aspensmonster-school/ee4390-senior-design-i/presentation/README

This folder holds presentation-related material.
