aspensmonster-school/ee4390-senior-design-i/hw/README

This folder will contain hardware schematics, netlists, models, simulation 
data, waveforms, etc for the project.
