aspensmonster-school/ee4390-senior-design-i/research/more-links.md

More links to reference
=======================

  * "Power Density Spectrum of noise types" - https://en.wikipedia.org/wiki/Colors_of_noise
  * "A whole paper on tests" - http://csrc.nist.gov/groups/ST/toolkit/rng/documents/nissc-paper.pdf
  * "Tests" - http://www.comp-phys.org/software/rngts/tests/RNGTS_tests.html
  * "Description of various tests" - http://www.drdobbs.com/testing-random-number-generators/184403185
  * "Adversary Bias" - http://www1.spms.ntu.edu.sg/~kkhoongm/Entropy.pdf
  * "Null Hypothesis, Type I and Type II Errors" - http://www.eg.bucknell.edu/~xmeng/Course/CS6337/Note/master/node42.html
  * "Autocorrelation when using multiple generators" - https://en.wikipedia.org/wiki/Autocorrelation
  * "Power Supply Bypassing of Op-Amps" - http://tangentsoft.net/audio/hs-opamp.html
  * "Noise Models in Op-Amps" - http://www.siengineer.com/images/Tutorial_on_Op_Amp_Noise.pdf
  * Several pages from robertnz.net
    * "Hardware RNGs" - http://www.robertnz.net/hwrng.htm
    * "True RNGs" - http://www.robertnz.net/true_rng.html
    * "Paper on XOR post-processing" - http://www.robertnz.net/pdf/xor2.pdf
  * "ISAAC CSPRNG; look at issues with seeding!" - http://www.robertnz.net/pdf/xor2.pdf
  * "Good practical advice on interpreting tests here" - http://burtleburtle.net/bob/rand/testsfor.html
  * "DIE GROUND LOOPS DIE" - http://www.edn.com/electronics-blogs/signal-integrity/4403657/Ground-loops
  * "Analog vs Digital ground" - http://analogvsdigitalground.blogspot.com/p/various-grounds.html
  * "Grounding Demystified" - http://www.celectronics.com/seminar/sample/IEEE11-9-05.pdf
  * "Apparently the world's foremost expert on ground loops" - http://www.jensen-transformers.com/an/generic%20seminar.pdf
  * "Both pink and white noise exist in amplifiers and other semiconductors" - http://www.edn.com/electronics-blogs/the-signal/4408242/1-f-Noise-the-flickering-candle-
  * "Comparing de-biasing routines" http://www1.spms.ntu.edu.sg/~kkhoongm/Entropy.pdf
  * "Lots of links to other resources" http://www.cs.berkeley.edu/~daw/rnd/
  * "haven't looked at" https://www.merrymeet.com/jon/usingrandom.html#RTFToC1
  * "haven't looked at" http://www.ciphersbyritter.com/RES/NOISE.HTM
  * "haven't looked at" http://world.std.com/~reinhold/truenoise.html
