aspensmonster-school/ee4390-senior-design-i/research/f^-1_noise Matthias Strauch.pdf

# 1/f noise

# Matthias Strauch

28.10.2011

# Repetition: Noise

# d =R⋅s+n

# White Noise→ Gaussian noise → signal independent

# But: There's frequency dependent noise!

n=

1
∣2π N∣

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
# Colours of noise

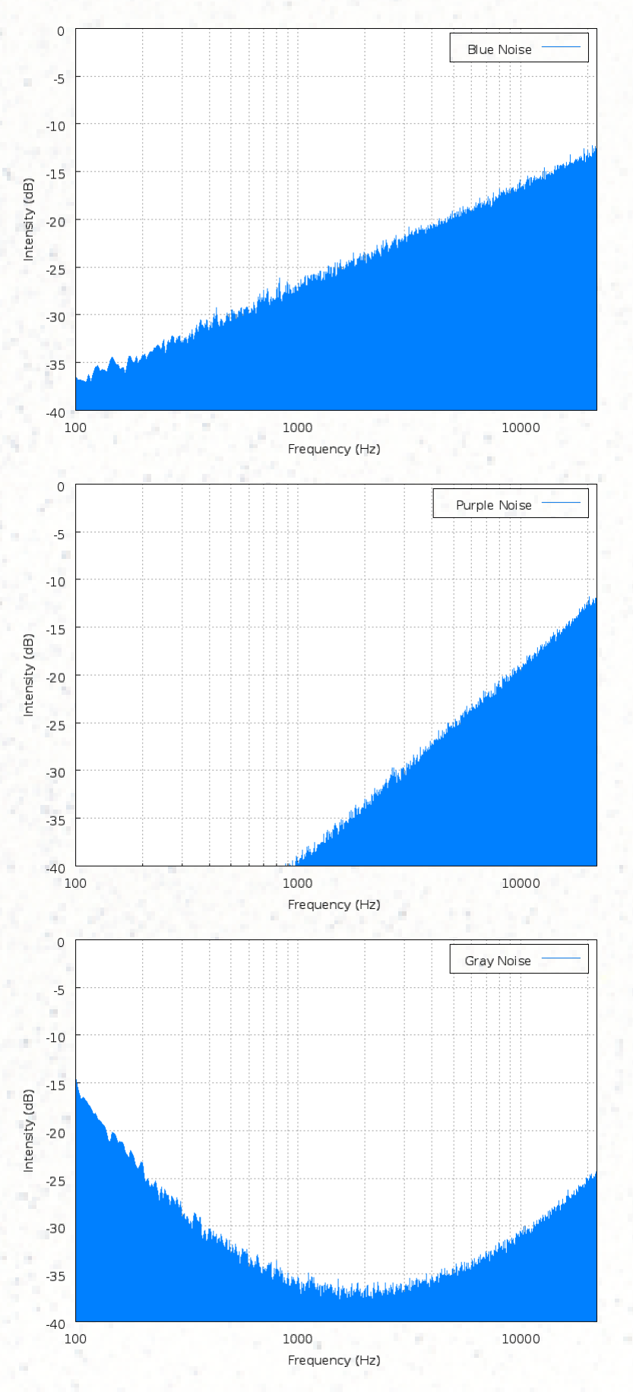
[picture p4: figure]

# - White

# - Pink

# - Brown

# - Blue

# - Violet

# - Grey

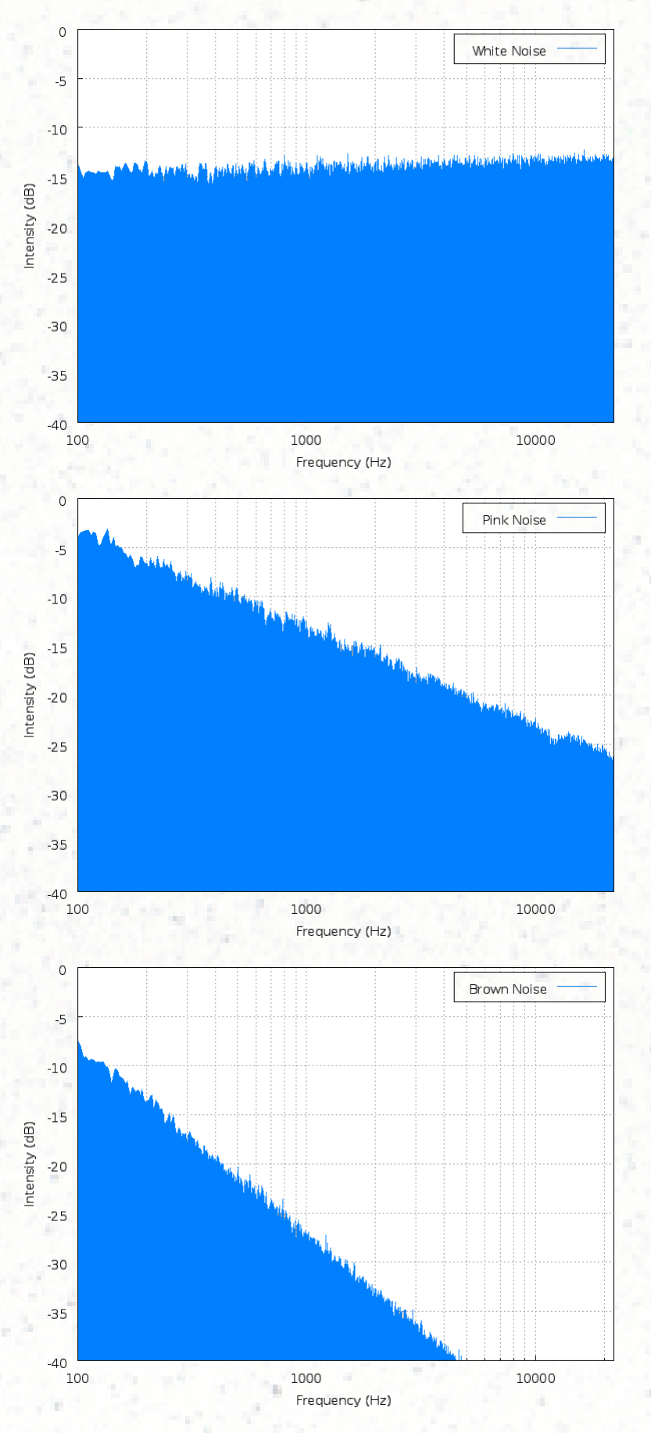
[picture p5: figure]

log(Noise power density) is plotted vs. log(f)

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
[1] Pictures created with Audacity

# Occurrence of noise

# - Acoustics - Visual - Electronic - Vibrational

# Kinds of electronic noise

# - Thermal (Johnson-Nyquist) noise - Shot noise - Burst noise - Avalanche noise - Flicker noise

# Measuring noise

# 1. Measure U/I 2. FFT 3. Calculate power density spectrum

# → Integrate over many measurements

# History of 1/f noise

- 1918
- 1925

# W. Schottky predicted the occurance of frequency-independent white noise

J. B. Johnson successfully measured it,

# but discovers unexpected “flicker noise” at low frequency

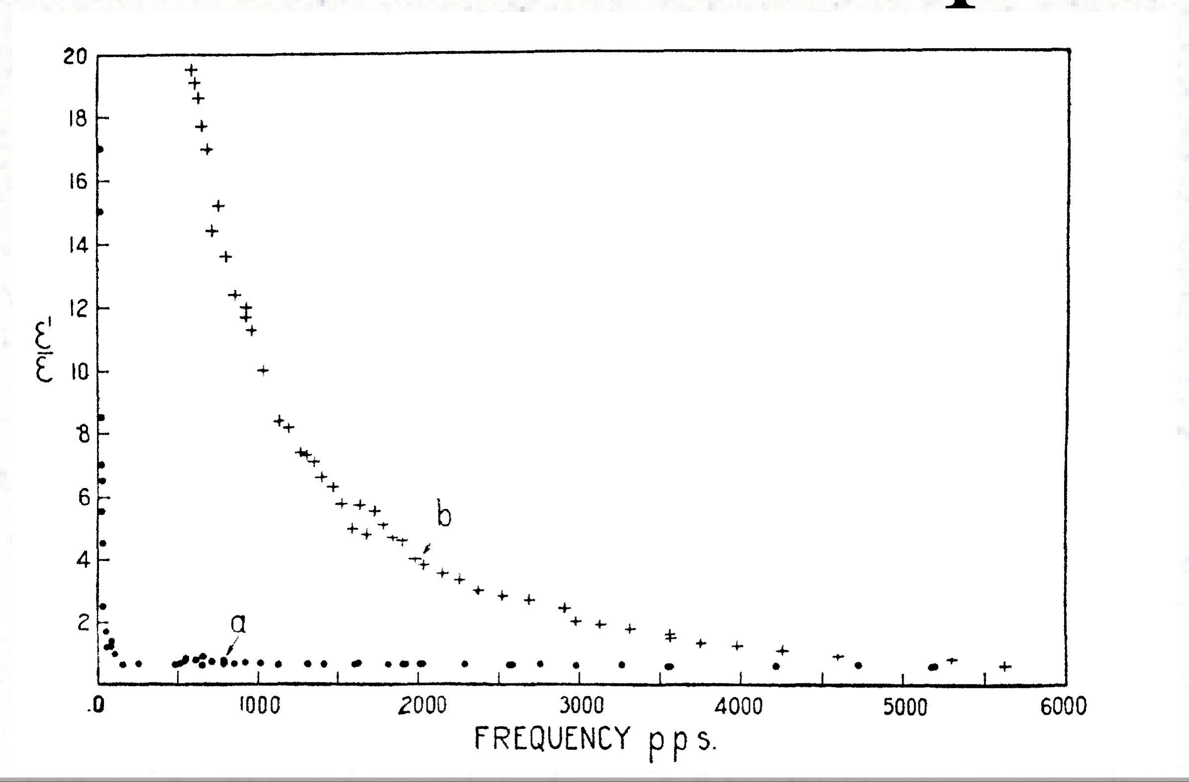
[picture p6: figure]

[2] W.Schottky Ann. d. Phys. 57 (1918) 157
[3] J.B. Johnson Phys. Rev. 26 (1925) 71

# Flicker Noise

# - behaviour

# - α range: 0.5 – 1.5

# - Extends: Several frequency decades!

1
f

α

# First explanation: W. Schottky 1926

# Ansatz: Superposition of relaxation processes N (t)=N0

e

−λ t
t≥0
F (ω)=∫

0

∞

# N (t)e

−iωt
=

N0

## λ+iω

# Now: Train of such pulses

F (ω)=∫

0

∞
∑

k

# N (t ,t

k

)e

−iωt
=

N0

## λ+iω∑

k

e

iωt
k

# N (t ,t

k

)=N0

e

−λ(t−t
k

)
t≥t
k
[4] W. Schottky, Phys. Rev. 28 (1926) 74

# Spectrum

# S (ω)=lim

t →∞

1
T

〈∣F (ω)∣

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
# n: average pulse rate

# → dependence 1

f

2

# 1/f dependence

S (ω)=

1
λ2−λ1

∫

λ1

λ2 N0
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
n | 0<ω≪λ1,λ2
N0

2
n π

## 2ω(λ1−λ2

)

## λ1≪ω≪λ2

N0

2
n
ω

2

## λ1, λ2≪ω ∣

# Uniform distributed relaxation rate between λ1, λ2

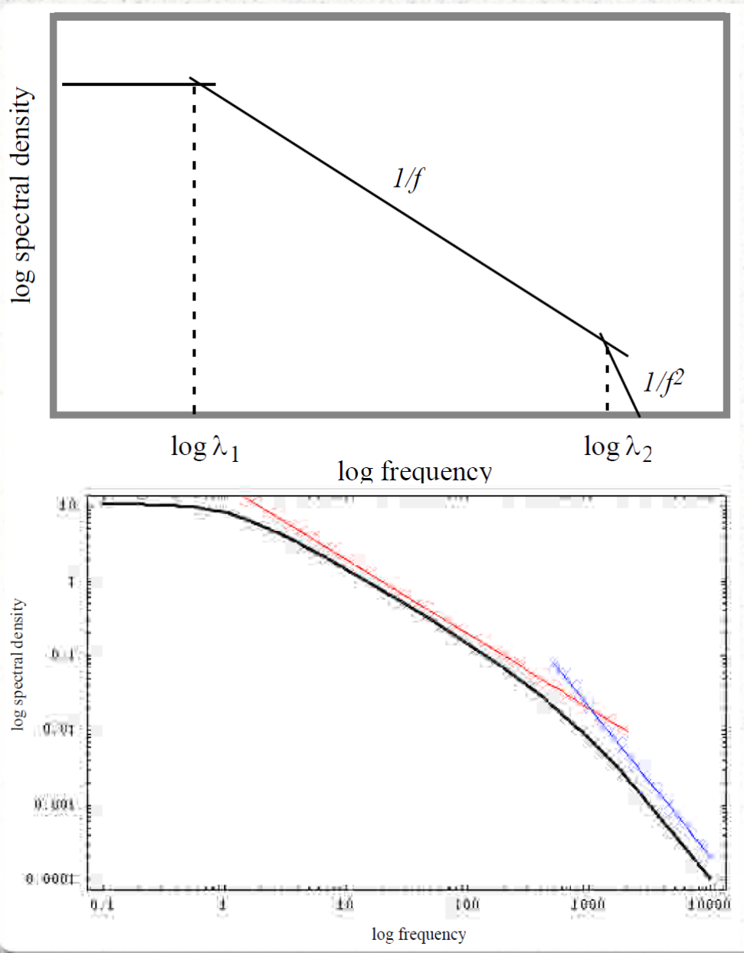
[picture p7: figure]

[5] E. Milotti arXiv:physics/0204033v1

# Non-uniform distribution

S (ω)∼

1
ω

1+β

# → Whole class of flicker noises with different exponents

# Infinitely large fluctuations?

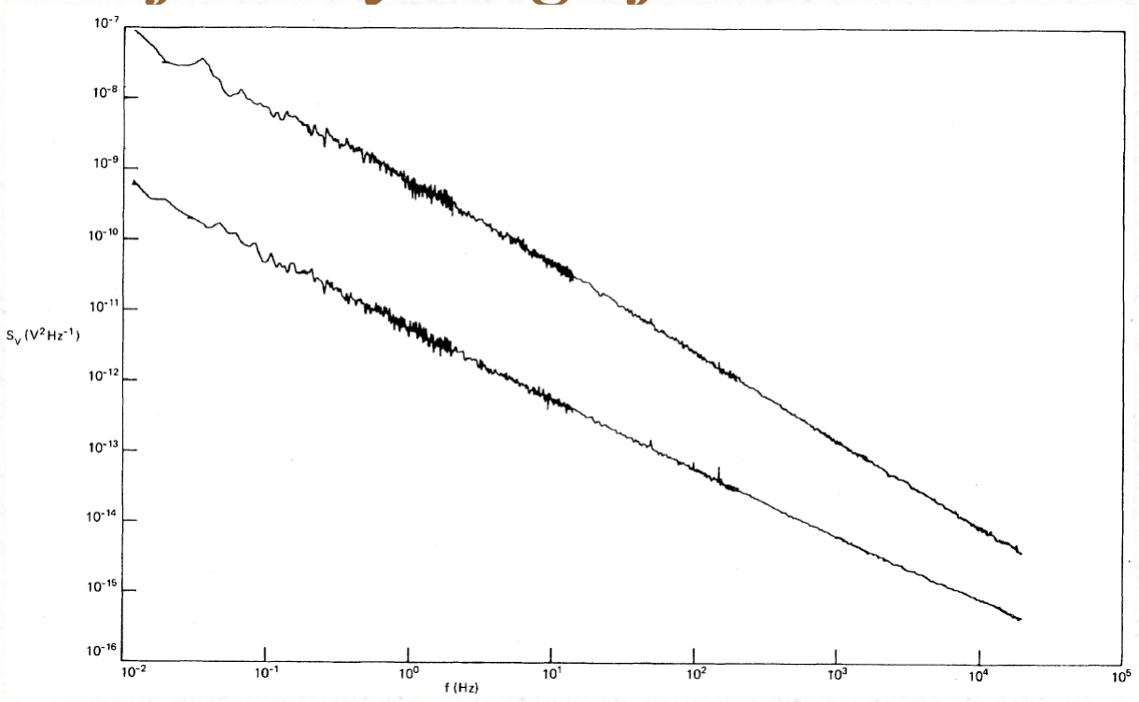
[picture p8: figure]

[6] B. Pellegrini, R.Saletti, P. Terreni and M. Prudenziati, Phys. Rev. B 27 (1983) 1233

# Don't worry!

∫

10⁻¹⁷ Hz

10⁴³ Hz df
f

# =ln(10⁶⁰)≈138

# Highest possible fluctuation can only be 138 times the total fluctuation between 1 Hz and 3 Hz

[7] I. Flinn Nature 219 (1968) 1356

# Investigation of Brownian motion

dx
dt

# =Gaussian(t)

# −iω X (ω)=Gaussian(ω)

S x
=

σ

2
2πω

2

Brownian motion has a | spectrum!
→ No description for | noise
| 1 f
| 2
1
f

# Diffusion processes

# In principle: - Possibility to derive flicker noise

# - But: No physical meaning

[8] P. Dutta and P. M. Horn, Rev. Mod. Phys. 17 (1945) 323
[9] E. Milotti Phys. Rev. E 51 (1995) 3087

# Bak Tang Wiesenfeld Model 1987

# - Sandpile model - Statistical approach: dependence - Numerical simulations: α near 1 - Confirmed by renormalization group Experiment: → Sandpiles doesn't behave like theory

## Reason: Calculation Error!

1
f

α

[10] P. Bak, C. Tang, K. Wiesenfeld, Phys. Rev. Lett. 59 (1987) 381
[11] H. M. Jaeger, C. Liu and S. R. Nagel, Phys. Rev. Lett. 62 (1989) 40
[12] H. J. Jensen, K. Christensen ans H. C. Fogedby, Phys. Rev. B 40 (1989) 7425

# Theoretical Conclusion:

# - Relaxation ansatz leads to wrong low and high frequency behaviour

# - Diffusion ansatz yields noise

# - Sandpile model not applicable

# → No true explanation yet

1
f

2

# Experiment: Sea Level at Bermuda

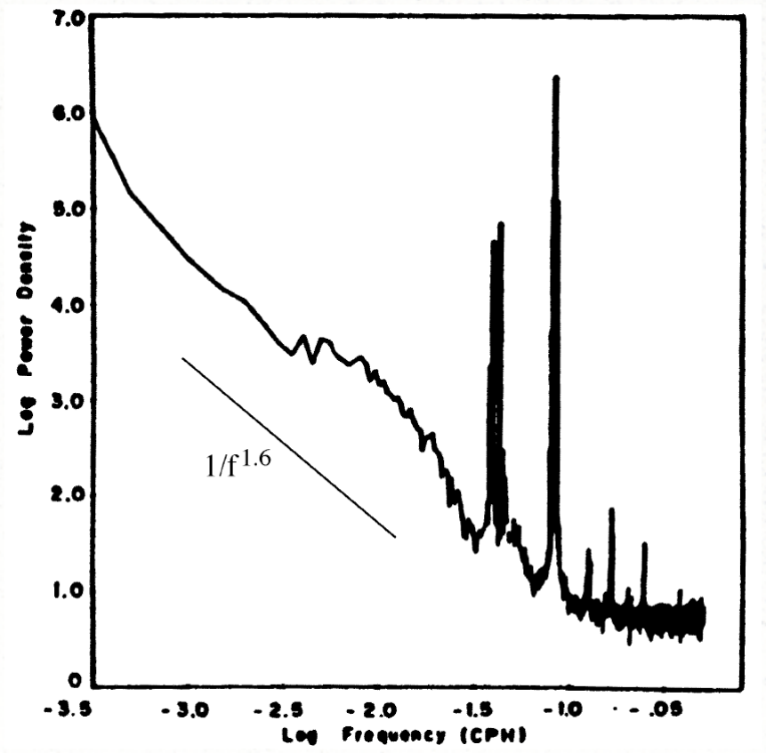
[picture p9: figure]

[13] C. Wunsch, Rev.
Geophys. and Space
Phys. 10 (1972) 1

# Loudness fluctuation spectra of different radio stations and Bach

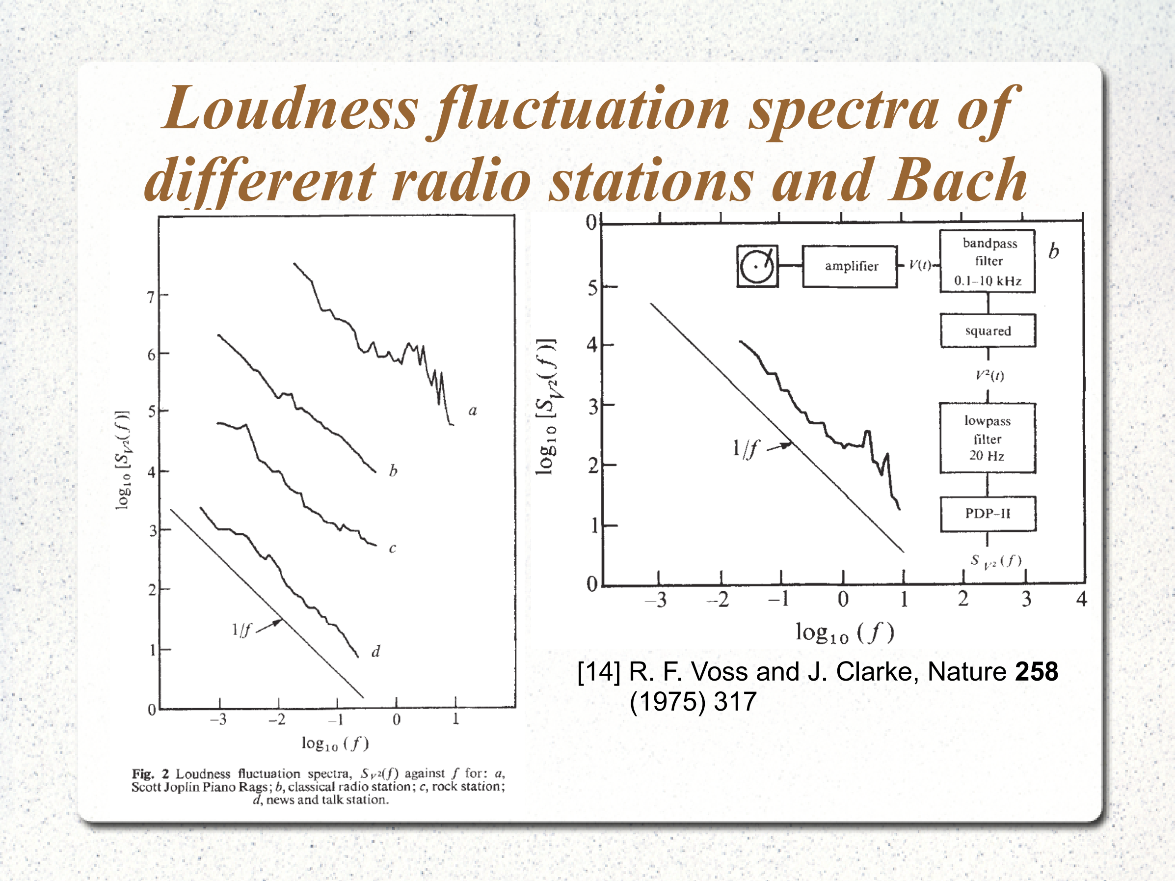
[picture p10: page 21]

[14] R. F. Voss and J. Clarke, Nature 258 (1975) 317

# Earthquakes 2000

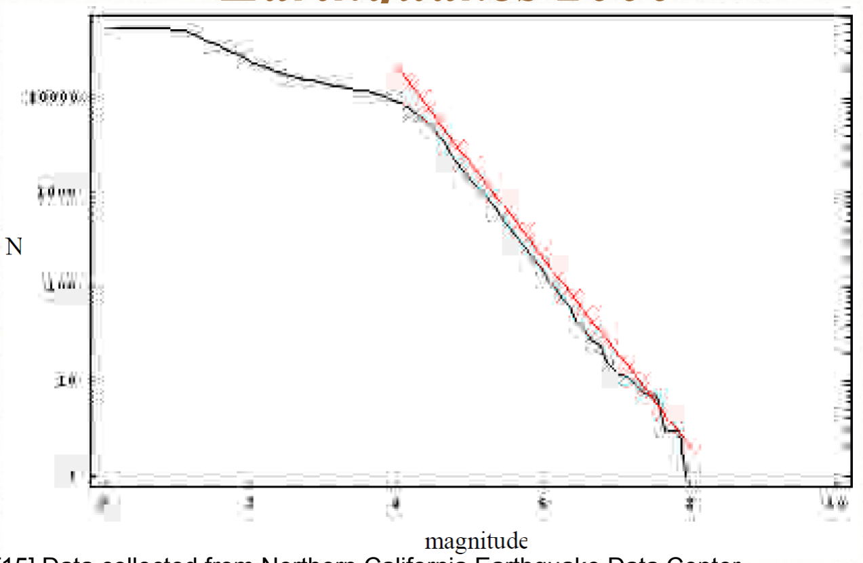
[picture p11: figure]

[15] Data collected from Northern California Earthquake Data Center http://quake.geo.berkeley.edu/

# Ohmic contacts

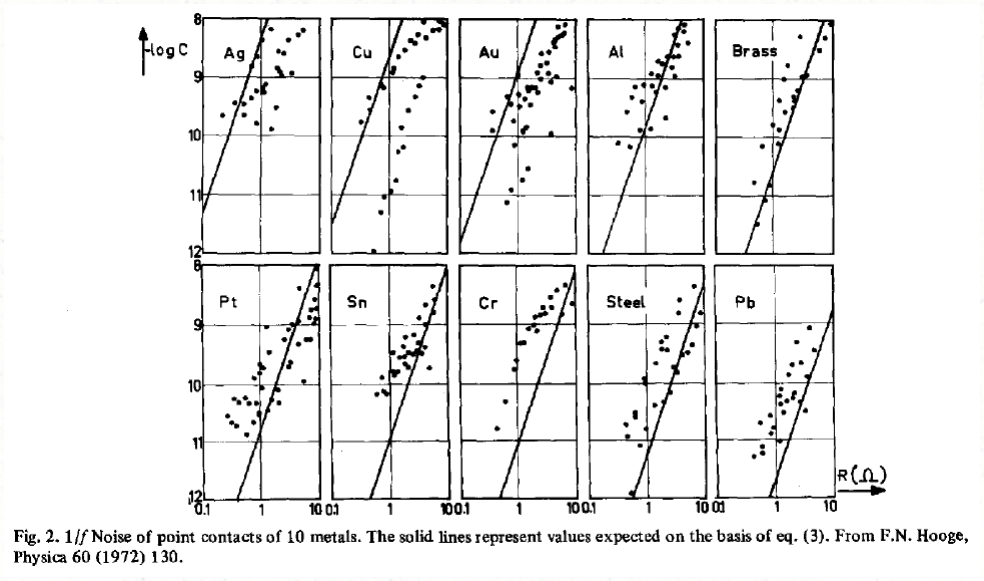
[picture p12: figure]

# TFTs

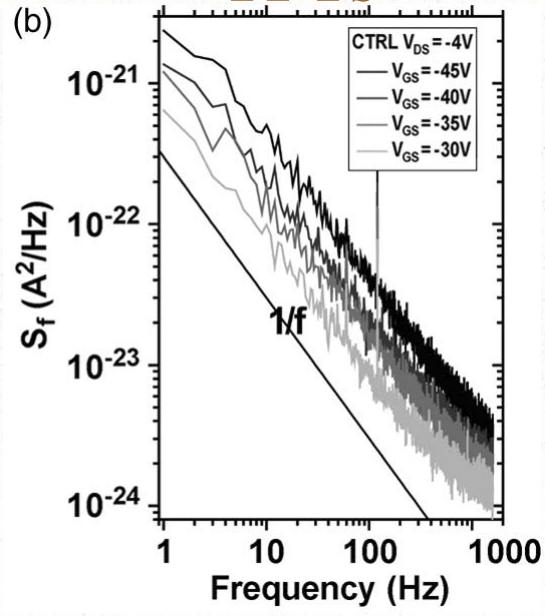
[picture p13: figure]

[17] IEEE Elec. Dev. Lett. 31 (2010) 1050

# Last slide

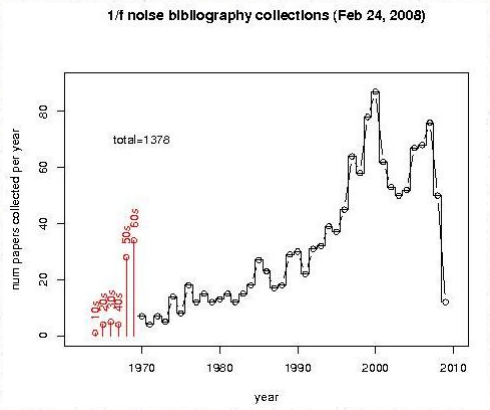
[picture p14: figure]

[18] http://www.nslij-genetics.org/wli/1fnoise/index.html

# Sources:

[1] Audacity 1.2.6 from http://audacity.sourceforge.net/?lang=de
[2] W. Schottky Ann. d. Phys. 57 (1918) 157
[3] J. B. Johnson Phys. Rev. 26 (1925) 71
[4] W. Schottky, Phys. Rev. 28 (1926) 74
[5] E. Milotti arXiv:physics/0204033v1
[6] B.Pellegrini, R.Saletti, P.Terreni and M.Prudenziati, Phys. Rev. B 27 (1983) 1233
[7] I. Flinn Nature 219 (1968) 1356
[8] P. Dutta and P. M. Horn, Rev. Mod. Phys. 17 (1945) 323
[9] E. Milotti Phys. Rev. E 51 (1995) 3087
[10] P. Bak, C. Tang, K. Wiesenfeld, Phys. Rev. Lett. 59 (1987) 381
[11] H. M. Jaeger, C. Liu and S. R. Nagel, Phys. Rev. Lett. 62 (1989) 40
[12] H. J. Jensen, K. Christensen ans H. C. Fogedby, Phys. Rev. B 40 (1989) 7425
[13] C. Wunsch, Rev. Geophys. and Space Phys. 10 (1972) 1
[14] R. F. Voss and J. Clarke, Nature 258 (1975) 317
[15] Northern California Earthquake Data Center: http://quake.geo.berkeley.edu/
[16] F. N. Hooge Physica 60 (1972) 130
[17] IEEE Elec. Dev. Lett. 31 (2010) 1050
[18] http://www.nslij-genetics.org/wli/1fnoise/index.html
