aspensmonster-school/ee4390-senior-design-i/research/scraped-from-electronic-noise-and-interfering-signals-principles-and-applications/av-3.png

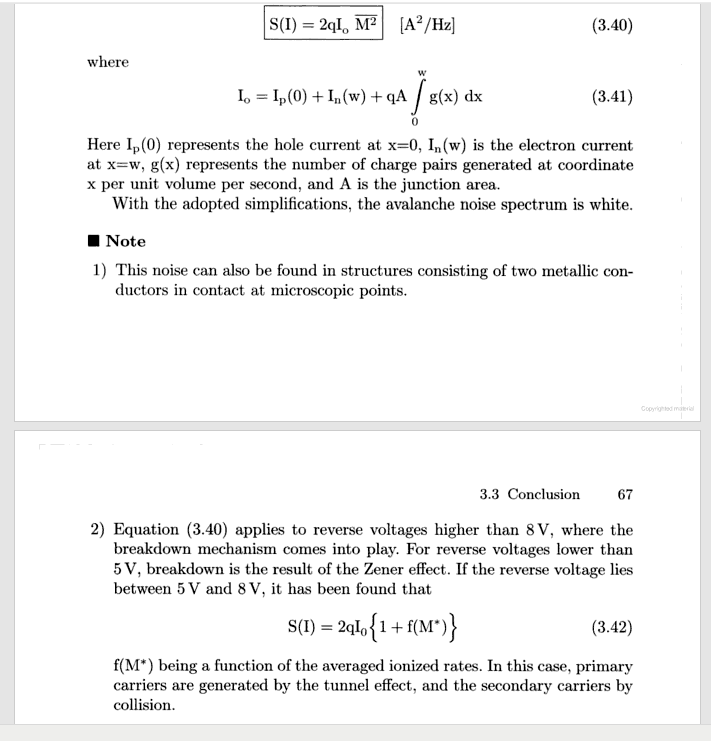
research/scraped-from-electronic-noise-and-interfering-signals-principles-and-applications/av-3.png
