aspensmonster-school/ee4390-senior-design-i/tests/README

This folder will hold the testing infrastructure for the project.
