aspensmonster-school/ee4390-senior-design-i/(commit log)

2013-09-19 Vazzana states that changing the current on the 2N3904 seems to change the noise pattern on the scope. Will need to investigate.
2013-09-23 More notes. infomaniac50 has a decent arduino library for debiasing bitstreams from a RNG. Should also look into VonNeumann debiasing more generally. Understand any weaknesses it may have.
2013-11-04 Just driving a transistor to saturation to get some random noise.
    [absolute-simplest.sch]
2013-11-04 Simulating is still difficult. Ugh.
    [absolute-simplest.sch]
2013-11-04 I've managed to get a decent simulation going. It's even got the noise floor about where it should be (around 500 mV). Awesome.
    [analog_only.sch]
2013-11-04 Final work for tonight. Time to go to bed.
2013-11-05 Something screwy with my netlist.
    [analog_only.sch]
2013-11-06 Got a rudimentary prototype up and running. Will bring to class.
2013-12-09 Adding to layout. Going to put this into a powerpoint soon. Also: I have the RNG up and running on 12V supply. Which is good, because I have a 8-AA plastic battery pack that I can use to power the br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
2013-12-09 Almost done with slides. Just going to use some of the slides for the posterboard too. The real meat of the posterboard session will be in demoing the prototype.
2013-12-09 Updated schematic slightly.
    [analog_only.sch]
2013-12-09 Adding source code for arduino monitor.
2014-01-29 Going to try reading from perl so that we don't have these messy Serial.print calls. The guy from TI who critqued my design at the poster session recommended getting rid of those.
2014-01-29 Well, apparently that pm isn't in CPAN. That's a first. Shouldn't be a problem to just use the base Device::SerialPort though.
2014-01-29 Starting to come together. Going to need to actually wire everything up pretty soon.
2014-02-18 Suspect I have the wrong voltage on the output of the comparator (it seems to just grab the supply voltage which would be too high for the arduino. Have I fried it? Let's hope not.
    [arduino_code.ino]
2014-03-03 Whoops. Off by one error. Fixed.
    [arduino_code.ino]
2014-03-26 Full schematic as of the time of this commit.
    [full.sch]
2014-03-26 CDR powerpoint.
2014-04-14 I think I might die of stress before I actually get to graduate.
